pdxbadgers/badge-2018/README.md

# badge-2018  
BSidesPDX 2018 badge

## Art  
image resouce files

## FW  
C source code

## HW  
KiCad soruce files, BOM, datasheets
