pdxbadgers/badge-2018/ART/README.md

# Useful links for KiCad art

## Videos
Kicad: Designing With Complex Shapes
https://www.youtube.com/watch?v=AfmdjmGnVgo

PCB Art Workshop // Andrew Sowa
https://www.youtube.com/watch?v=-QPkSICzRDk

How I make Shitty Add-ons
https://www.youtube.com/watch?v=61NFK9KW_4s

AND!XOR Getting To Shitty
https://www.youtube.com/watch?v=SKk8s5KAhKs

Creating Custom Footprints in KiCad 4.0.7
https://www.youtube.com/watch?v=q4AOZqNYESA

Converting Custom Footprints Into Zones in KiCad 4.0.7
https://www.youtube.com/watch?v=H-Lc91iaH6w

## Blogs
http://www.andrewsowa.com/blog/2017/3/19/creating-the-benchoff-nickel  
https://nitkin.net/2016/3/graphic-copper-kicad  
https://medium.com/@urish/a-practical-guide-to-designing-pcb-art-b5aa22926a5c  
https://andrehessling.de/2016/09/13/getting-a-custom-board-outline-from-an-svg-file-into-kicad/

## Forum
https://forum.kicad.info/t/how-to-make-no-copper-no-mask-complex-shape/11651/5  
https://forum.kicad.info/t/exposed-copper-pour-fill-zones-pour-with-no-solder-mask/2474/14  
https://graphicdesign.stackexchange.com/questions/48748/is-it-possible-to-invert-an-svg-file-not-the-colours-but-the-actual-areas-pa
