pdxbadgers/badge-2018/HW/README.md

## Resources
passive compoenent footprints: https://github.com/esden/pretty-kicad-libs  
SAO symbol and footprint: https://hackaday.io/project/52950-defcon-26-shitty-add-ons
DigiKey symbols and footprints: https://www.digikey.com/en/resources/design-tools/kicad
