pdxbadgers/badge-2018/ART/1.png

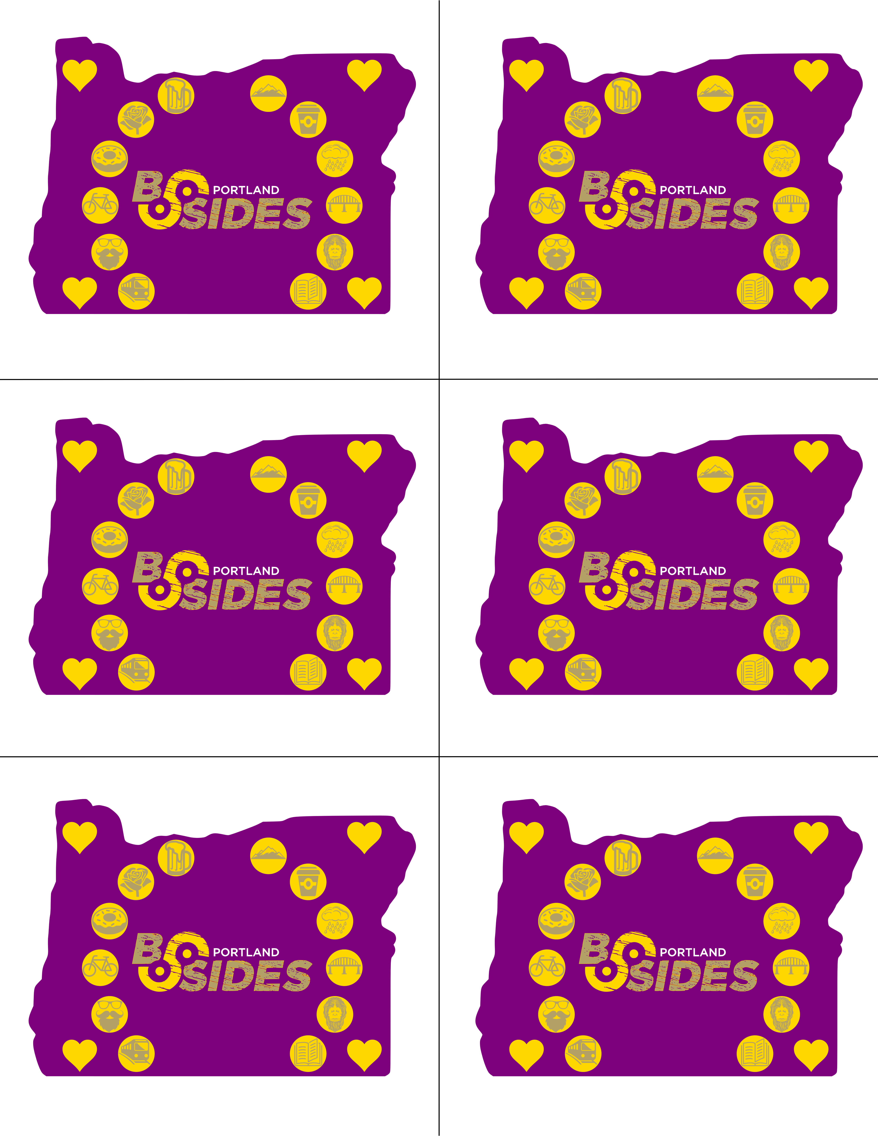
ART/1.png
