pdxbadgers/badge-2018/ART/2.png

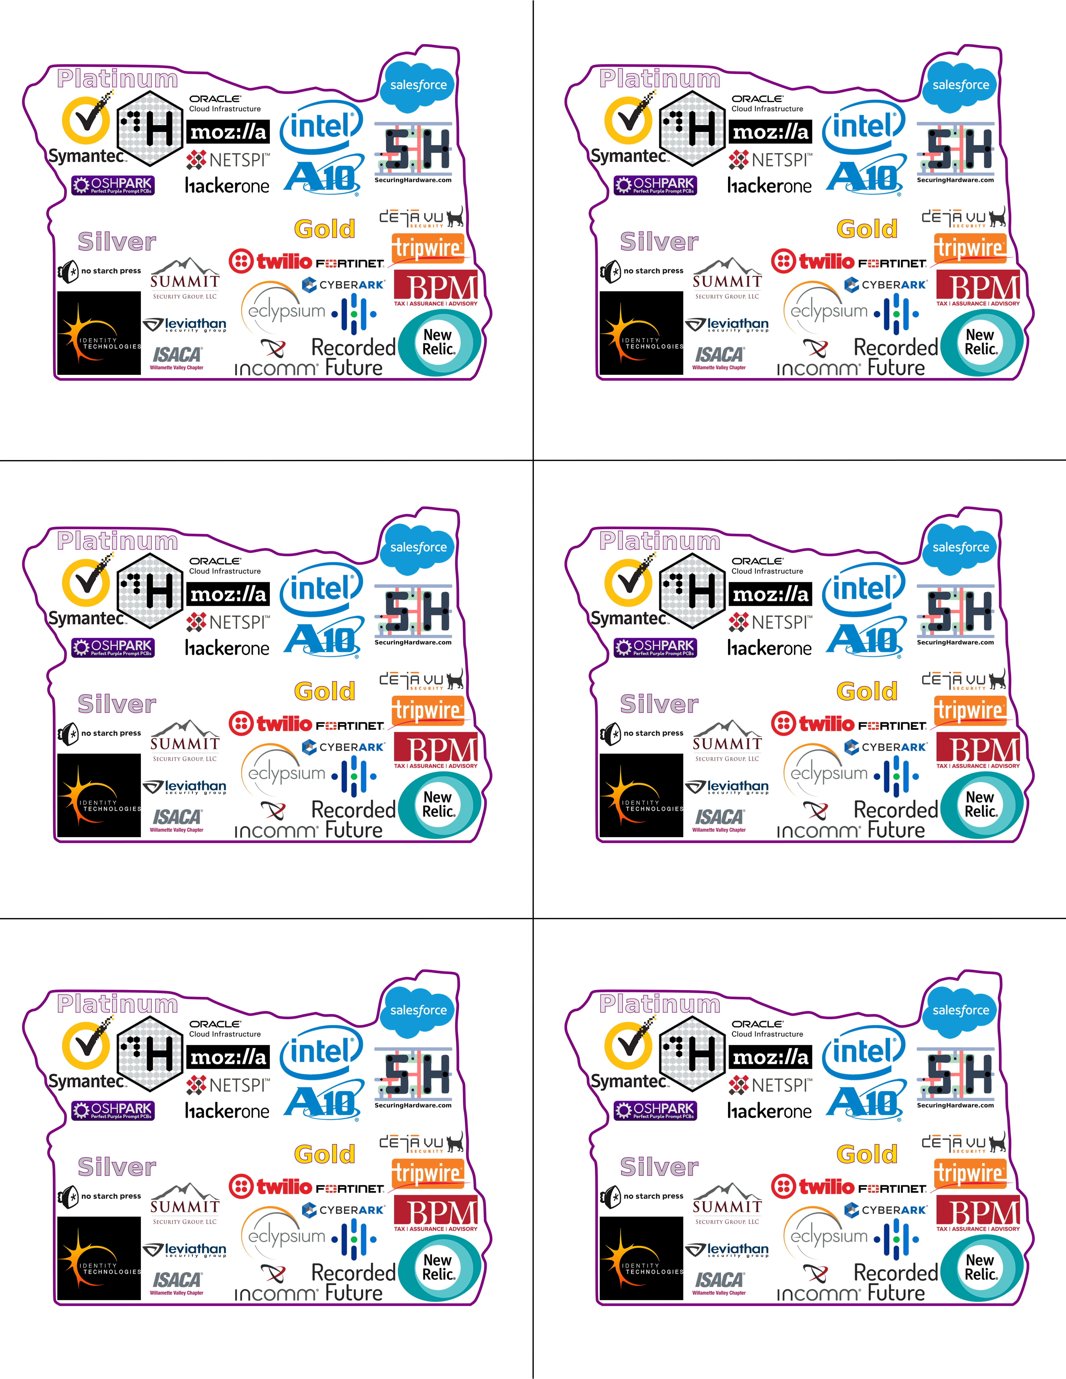
ART/2.png
