pdxbadgers/badge-2018/HW/BSidesPDX_2018/BSidesPDX_2018.kicad_pcb

## KiCad design HW/BSidesPDX_2018/BSidesPDX_2018.kicad_pcb (2018-09-19)

Schematic: BSidesPDX_2018.sch, BSidesPDX 2018 Badge

Parts:
BT1: Battery_Cell; CR2030_Retainer
C1: 10u; C_0805
C2: 0.1u; C_0603
D1, D2, D3, D4, D5, D6, D7, D8, D9, D10, D11, D12: YLW_LED; OSRAM_LED
D13, D14: D_Zener; D_SOD-323
D101, D102, D103, D104: RGB_LED
J1: AVR-ISP-6; AVR_ISP_2x3_P2.54mm_SMD
J2: USB_B_Micro
R1, R2, R3, R4, R101, R102, R103, R104: 100R; C_0603
R5, R6: 68R; C_0603
R7: 1K5; C_0603
S1, S2: PTS645SM43SMTR92_LFS; Switch_Tactile_SMD_6x6mm_PTS645; MPN PTS645SM43SMTR92 LFS; Digi-Key_PN CKN9112CT-ND
U1: ATTINY861-15XD; TSSOP-20_4.4x6.5mm_P0.65mm
X1, X2, X3, X4: Badgelife_shitty_connector; PRESS_FIT_SAO_CNX

Connections:
/3V0: BT1.1, C1.1, C2.1, J1.2, J2.1, R7.1, U1.5 (VCC), U1.15 (AVCC), X1.1, X2.1, X3.1, X4.1
/B_PWM__D+: D101.4, D102.4, D103.4, D104.4, R5.1, U1.8 (XTAL2/PB5)
/D+: D13.1, J2.3, R5.2
/D-: D14.1, J2.2, R6.1, R7.2
/EN_RGB1: R101.1, U1.14 (PA4)
/EN_RGB2: R102.1, U1.13 (PA5)
/EN_RGB3: R103.1, U1.12 (PA6)
/EN_RGB4: R104.1, U1.11 (PA7)
/G_PWM: D101.3, D102.3, D103.3, D104.3, U1.4 (PB3)
/L_SWITCH_D-: R6.2, S1.1, S1.2, U1.7 (XTAL1/PB4)
/NC: J2.4
/ROW1: R1.1, U1.20 (PA0)
/ROW2: R2.1, U1.19 (PA1)
/ROW3: R3.1, U1.18 (PA2)
/ROW4: R4.1, U1.17 (AREF/PA3)
/ROW_1: D1.2, D2.2, D3.2, D4.1, D7.1, D8.1, R1.2
/ROW_2: D1.1, D4.2, D5.2, D6.2, D9.1, D10.1, R2.2
/ROW_3: D2.1, D5.1, D8.2, D10.2, D11.1, D12.2, R3.2
/ROW_4: D3.1, D6.1, D7.2, D9.2, D11.2, D12.1, R4.2
/R_PWM__MISO: D101.1, D102.1, D103.1, D104.1, J1.1, U1.2 (PB1)
/R_SWITCH: S2.1, S2.2, U1.9 (PB6)
/SCL_SCK: J1.3, U1.3 (PB2), X1.3, X2.3, X3.3, X4.3
/SDA_MOSI: J1.4, U1.1 (PB0), X1.4, X2.4, X3.4, X4.4
/~RESET: J1.5, U1.10 (~RESET~/PB7)
GND: BT1.2, C1.2, C2.2, D13.2, D14.2, J1.6, J2.5, J2.6, S1.3, S1.4, S2.3, S2.4, U1.6 (GND), U1.16 (AGND), X1.2, X2.2, X3.2, X4.2
unnamed: D101.2, R101.2
unnamed: D102.2, R102.2
unnamed: D103.2, R103.2
unnamed: D104.2, R104.2

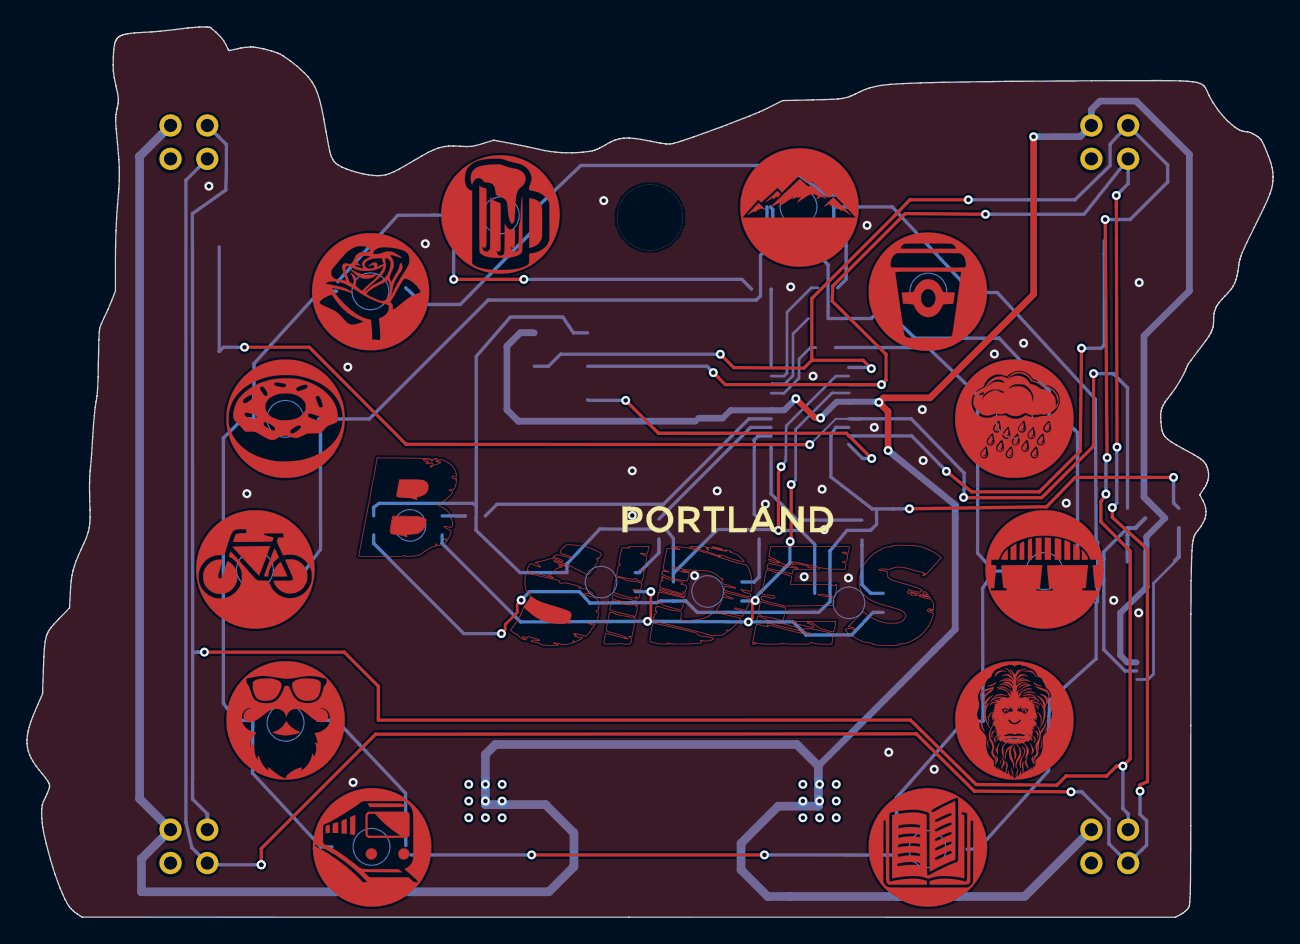
[picture p3: board BSidesPDX_2018.kicad_pcb from above]

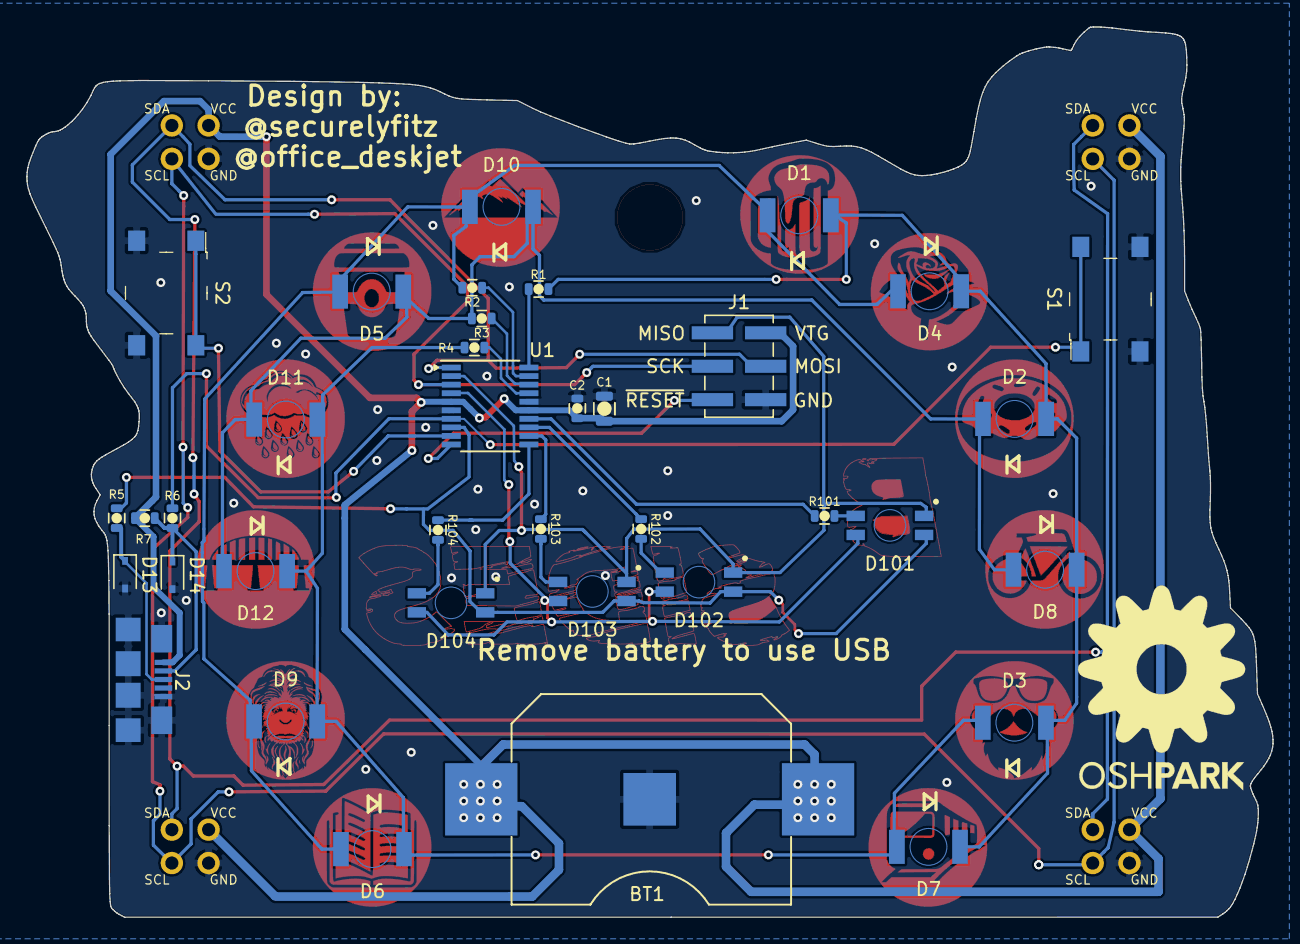
[picture p4: board BSidesPDX_2018.kicad_pcb from below]

Board: 2 copper layers, 94.7 x 67.7 mm, 44 parts (21 on the bottom side), 28 nets.

Other parts of the board:
ART_Cu: LOGO; F_Cu
MASK_ART: LOGO; F_Mask
PDX: LOGO; F_Silk
