pdxbadgers/badge-2018/(threads)

Thread 1 (2018-09-04):

USB support

office-deskjet, 2018-09-04:
Add USB connector and footprint, wire into button pins.
Add two series resistors VALUE?
Add one pullup resistor VALUE?

securelyfitz, 2018-09-17:
68 ohm series resistors
1.5k pullup resistor
