pdxbadgers/badge-2018/(commit log)

2018-09-04 reloading everyting
    [BOM.csv, BSidesPDX_2018.kicad_pcb, BSidesPDX_2018.sch]
2018-09-04 added SAO connector to local library. Added 5 SAO to schematic
    [BSidesPDX_2018.sch]
2018-09-04 added SAO connectors, wires, and labels
    [BSidesPDX_2018.sch]
2018-09-04 Added PWM busses and RGB LEDs
    [BSidesPDX_2018.sch]
2018-09-04 Added resistor values. Added the first leg of CharliePlex LEDs
    [BSidesPDX_2018.sch]
2018-09-04 added MCU datasheet, added charlieplex LEDs, and MCU to schematic
    [BOM.csv, BSidesPDX_2018.sch]
2018-09-04 lable RGB leds
    [BSidesPDX_2018.sch]
2018-09-04 fixed wires on RGB, LED, MCU and caps.
    [BSidesPDX_2018.sch]
2018-09-04 Fixed code directory. added ISP header, wired up PWM bussed
    [RGB_PWM_test.ino]
2018-09-04 adding files to match the previous commit
    [BSidesPDX_2018.sch]
2018-09-04 wired up ISP header, SAO I2C, and PWM
    [BSidesPDX_2018.sch]
2018-09-04 Wired, labeled, annotated charlieplex LEDs
    [BSidesPDX_2018.sch]
2018-09-04 Building BOM, added switches
    [BOM.csv, BSidesPDX_2018.sch]
2018-09-04 Added more parts to BOM
    [BOM.csv]
2018-09-04 adding footprints
    [BOM.csv, BSidesPDX_2018.sch]
2018-09-05 added Resistor and Capacitors to BOM
    [BOM.csv]
2018-09-05 Added batteries, LEDs and misc to BOM
    [BOM.csv]
2018-09-05 added a README for hardwre, updated footprints
    [BSidesPDX_2018.sch]
2018-09-05 Added LED and battery retainer datasheets. Added footprint for battery retainer. Update footprints in schematic.
    [BSidesPDX_2018.sch]
2018-09-05 added press fit SAO connector, updated SAO footprints, added schematic for USB connecotr
    [BSidesPDX_2018.sch]
2018-09-05 Corrected footprint for MCU. Updated USB parts
    [BSidesPDX_2018.sch]
2018-09-05 removed USB connector, it will move to addon
    [BSidesPDX_2018.sch]
2018-09-06 added foot print for programming header. Footpints are now assigned.
    [BSidesPDX_2018.sch]
2018-09-06 Adding SVG sources and links. fixing up board art
2018-09-06 adding solder mask for art
2018-09-07 adding generating kicad board art
    [board_art.kicad_pcb, board_art.sch]
2018-09-08 removed bottom SAO, Added USB back, updated library paths
    [BSidesPDX_2018.sch, board_art.kicad_pcb, board_art.sch]
2018-09-08 Removed temp art and mergered it into main project board.
    [BSidesPDX_2018.kicad_pcb, board_art.kicad_pcb]
2018-09-08 updated BOM, but missing resistor links. Updated Footprints
    [BOM.csv, BSidesPDX_2018.sch]
2018-09-09 Updated BOM USB connector, added USB footprint, updated ISP footprint, assigned footprints
    [BOM.csv, BSidesPDX_2018.sch]
2018-09-09 Layout work, added Datasheet for USB connector, fixed OSRAM_LED footprint, Fixed AVR ISP footprint.
    [BSidesPDX_2018.kicad_pcb, BSidesPDX_2018.sch]
2018-09-09 added OSHPark art, placed parts
    [BSidesPDX_2018.kicad_pcb]
2018-09-10 changed library settings, changed charliplexing circuit, fixed USB resistor
    [BSidesPDX_2018.kicad_pcb, BSidesPDX_2018.sch]
2018-09-10 Moved foot prints from libraries to locally.
    [BSidesPDX_2018.kicad_pcb, BSidesPDX_2018.sch]
2018-09-10 fixed avr isp orientation
    [BSidesPDX_2018.kicad_pcb]
2018-09-10 routed all leds, sao data lines. TO DO: 1. route power. i don't know how to change traces to larger lines in kicad 2. fix usb pins to connect to button pins instead. i still can't change schematic 3.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
    [BSidesPDX_2018.kicad_pcb]
2018-09-10 adding Joe's layout
    [BSidesPDX_2018.kicad_pcb]
2018-09-10 added zener diodes to USB data pins, changed wiring for USB data. PASS DRC
    [BSidesPDX_2018.sch]
2018-09-10 power mostly routed, most signals routed
    [BSidesPDX_2018.kicad_pcb]
2018-09-10 layout done, FAILS DRC
    [BSidesPDX_2018.kicad_pcb]
2018-09-10 fixing drc issues
    [BSidesPDX_2018.kicad_pcb]
2018-09-10 fixing drc issues, now 40
    [BSidesPDX_2018.kicad_pcb]
2018-09-10 filled in lower B with copper, layout looks googd
    [BSidesPDX_2018.kicad_pcb]
2018-09-10 fixed up ground connections, Added bottom silks
    [BSidesPDX_2018.kicad_pcb]
2018-09-10 tying some vias through gnd to give physical attachmentwq
    [BSidesPDX_2018.kicad_pcb]
2018-09-11 Updated BOM, disconnected USB ID Pin
    [BOM.csv, BSidesPDX_2018.kicad_pcb, BSidesPDX_2018.sch]
2018-09-11 finialized bom, but caps could change!
    [BOM.csv]
2018-09-11 exproted spreadsheet to CSV. Finialized BOM
    [BOM.csv]
2018-09-17 adding detail to firmware readme, plus sample code
2018-09-17 cleaned up USB schematic, changed USB resistor values. fixed shorted traces around LED apature
    [BSidesPDX_2018.kicad_pcb, BSidesPDX_2018.sch]
2018-09-17 fixed the battery foot print and updated the layout. Thickened the VCC traces. moved the SDA_MISO and SLC_SCK traces to make room for thick VCC trace. export new netlist for chages to USB block. Ran 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
    [BSidesPDX_2018.kicad_pcb]
2018-09-17 marked pin 1 on U1. Updated ReadMe
    [BSidesPDX_2018.kicad_pcb]
2018-09-17 fixed OSH Park logo
    [BSidesPDX_2018.kicad_pcb]
2018-09-17 for some reason the YLW_LEDs got Silk on their pads. Removed silk from foot print and updated layout.
    [BSidesPDX_2018.kicad_pcb]
2018-09-18 Moved Art logo and ref labels to F.Fab layer. Added copper pours to F_Cu. removed some vias from pcb
    [BSidesPDX_2018.kicad_pcb]
2018-09-18 moved logo and ref to fab layer
    [BSidesPDX_2018.kicad_pcb]
2018-09-18 Move AVR ISP footprint to front layer, added copper around S, moved battery holder up a bit
    [BSidesPDX_2018.kicad_pcb]
2018-09-18 fixed ISCP header
    [BSidesPDX_2018.kicad_pcb]
2018-09-18 tried to fix art work, moved labels in Silk layer, updated layout
    [BSidesPDX_2018.kicad_pcb]
2018-09-19 BAD HACK: I edited the txt file of the LED footrpint, then updated all footprints in the schematic, then tweaked a few things. Someone competent should check this!
    [BSidesPDX_2018.kicad_pcb]
2018-09-19 fixed RGB_LED sik layer. Updated layout, fixed one trace on D10
    [BSidesPDX_2018.kicad_pcb]
2018-09-19 fix disconnected LED
    [BSidesPDX_2018.kicad_pcb]
2018-09-19 moved cap refs
    [BSidesPDX_2018.kicad_pcb]
2018-09-19 cleaned up traces to yellow LEDs. DRC passes. Visually checked no traces through led copper ring
    [BSidesPDX_2018.kicad_pcb]
2018-09-19 added gerbers
    [BSidesPDX_2018-B.Cu.gbr, BSidesPDX_2018-B.Mask.gbr, BSidesPDX_2018-B.SilkS.gbr, BSidesPDX_2018-Edge.Cuts.gbr, BSidesPDX_2018-F.Cu.gbr, BSidesPDX_2018-F.Mask.gbr, BSidesPDX_2018-F.SilkS.gbr, BSidesPDX_2018.drl]
2018-09-19 redid ground pour. Updated USB Resistors in BOM
    [BOM.csv, BSidesPDX_2018.kicad_pcb]
2018-09-30 added led documentation, reading fuse bits
    [led_mapping.csv]
2018-10-04 LED blink code, delay time wrong
    [charlieplex_test.ino]
2018-10-18 Adding printout template, paper art
2018-10-21 Added Fuse programming to Makefile to set clock to 8Mhz
2018-10-22 added test code for RGB PWM, looks like LEDs are wired wrong
    [RGB_LED_test.ino, charlieplex_test.ino]
2018-10-23 RGB PWM test code
2018-10-23 G and B are wrong in foot print. Need to fix in FW
    [RGB_LED_test.c]
2018-10-24 converting arduino code to avr-libc
2018-10-24 compiles without error, no runtime testing
    [charlieplex.c]
2018-10-24 charleplex code works correctlygit status
    [charlieplex.c]
2018-10-24 Making an RGB LED test project, not PWM!
2018-10-24 working on RGB LED test code
2018-10-24 got the correct mapping for PWM pins
    [RGB_LED_test.c]
2018-10-24 RBG LED test code works correctly
    [RGB_LED_test.c]
2018-10-24 understanding the PWM registers
2018-10-24 red pwm ok
2018-10-24 got the pins right for PWM
2018-10-24 RBG PWM working, doing all colors one LED at a time
2018-10-24 RGB PWM code done. Cycles R, G, B per each LED
2018-10-24 added test code for implementing the RGB PWM via a timer ISR. copied coder from RGB PWM test
2018-10-24 init functions for timers
2018-10-24 fixing up timer init to 125Khz
    [timer_test.c]
2018-10-24 pin toggles in for loop, but at 360Khz, code in ISR not running
2018-10-24 timer0 configured correctly, loop code works, no test on ISR
    [timer_test.c]
2018-10-24 time frequency correct, but ISR not happening
    [timer_test.c]
2018-10-24 fixed typo for enabling interrupt timer0, works now
    [timer_test.c]
2018-10-24 got the ISR working. Gave up on having two ISR for A and B. Implemented a software timer using OCR0A
2018-10-24 PWM one led all colors via timer ISR works
2018-10-24 All RGB Leds now work on timer/ISR. had to change the timer frequency to get rid of delay in lighting the 103 104 LEDS.
2018-10-24 new project, combine led code together
2018-10-24 combining all the led code into all_leds.c
2018-10-24 adding code for yellow led speed chnaing with button R_SWITCH
2018-10-24 button press plays well with rgb leds
2018-10-24 getting random yellow led blink
2018-10-25 Yellow LED patter works with button. Button debounce is horrible.
2018-10-25 tried different timming for button, still bad debounce.
2018-10-30 disabling RGB LEDs
